fqynx/ESP32/(commit log)

2026-08-21 Add files via upload
    两轮差速式自主移动机器人底盘系统
2026-08-21 上位机代码
    [xsmrobot.urdf]
